orioltobar/shutter_automation/hardware/schemes/shutters.kicad_pcb

## KiCad design ESP32-S3/ESP32-S3.kicad_sch

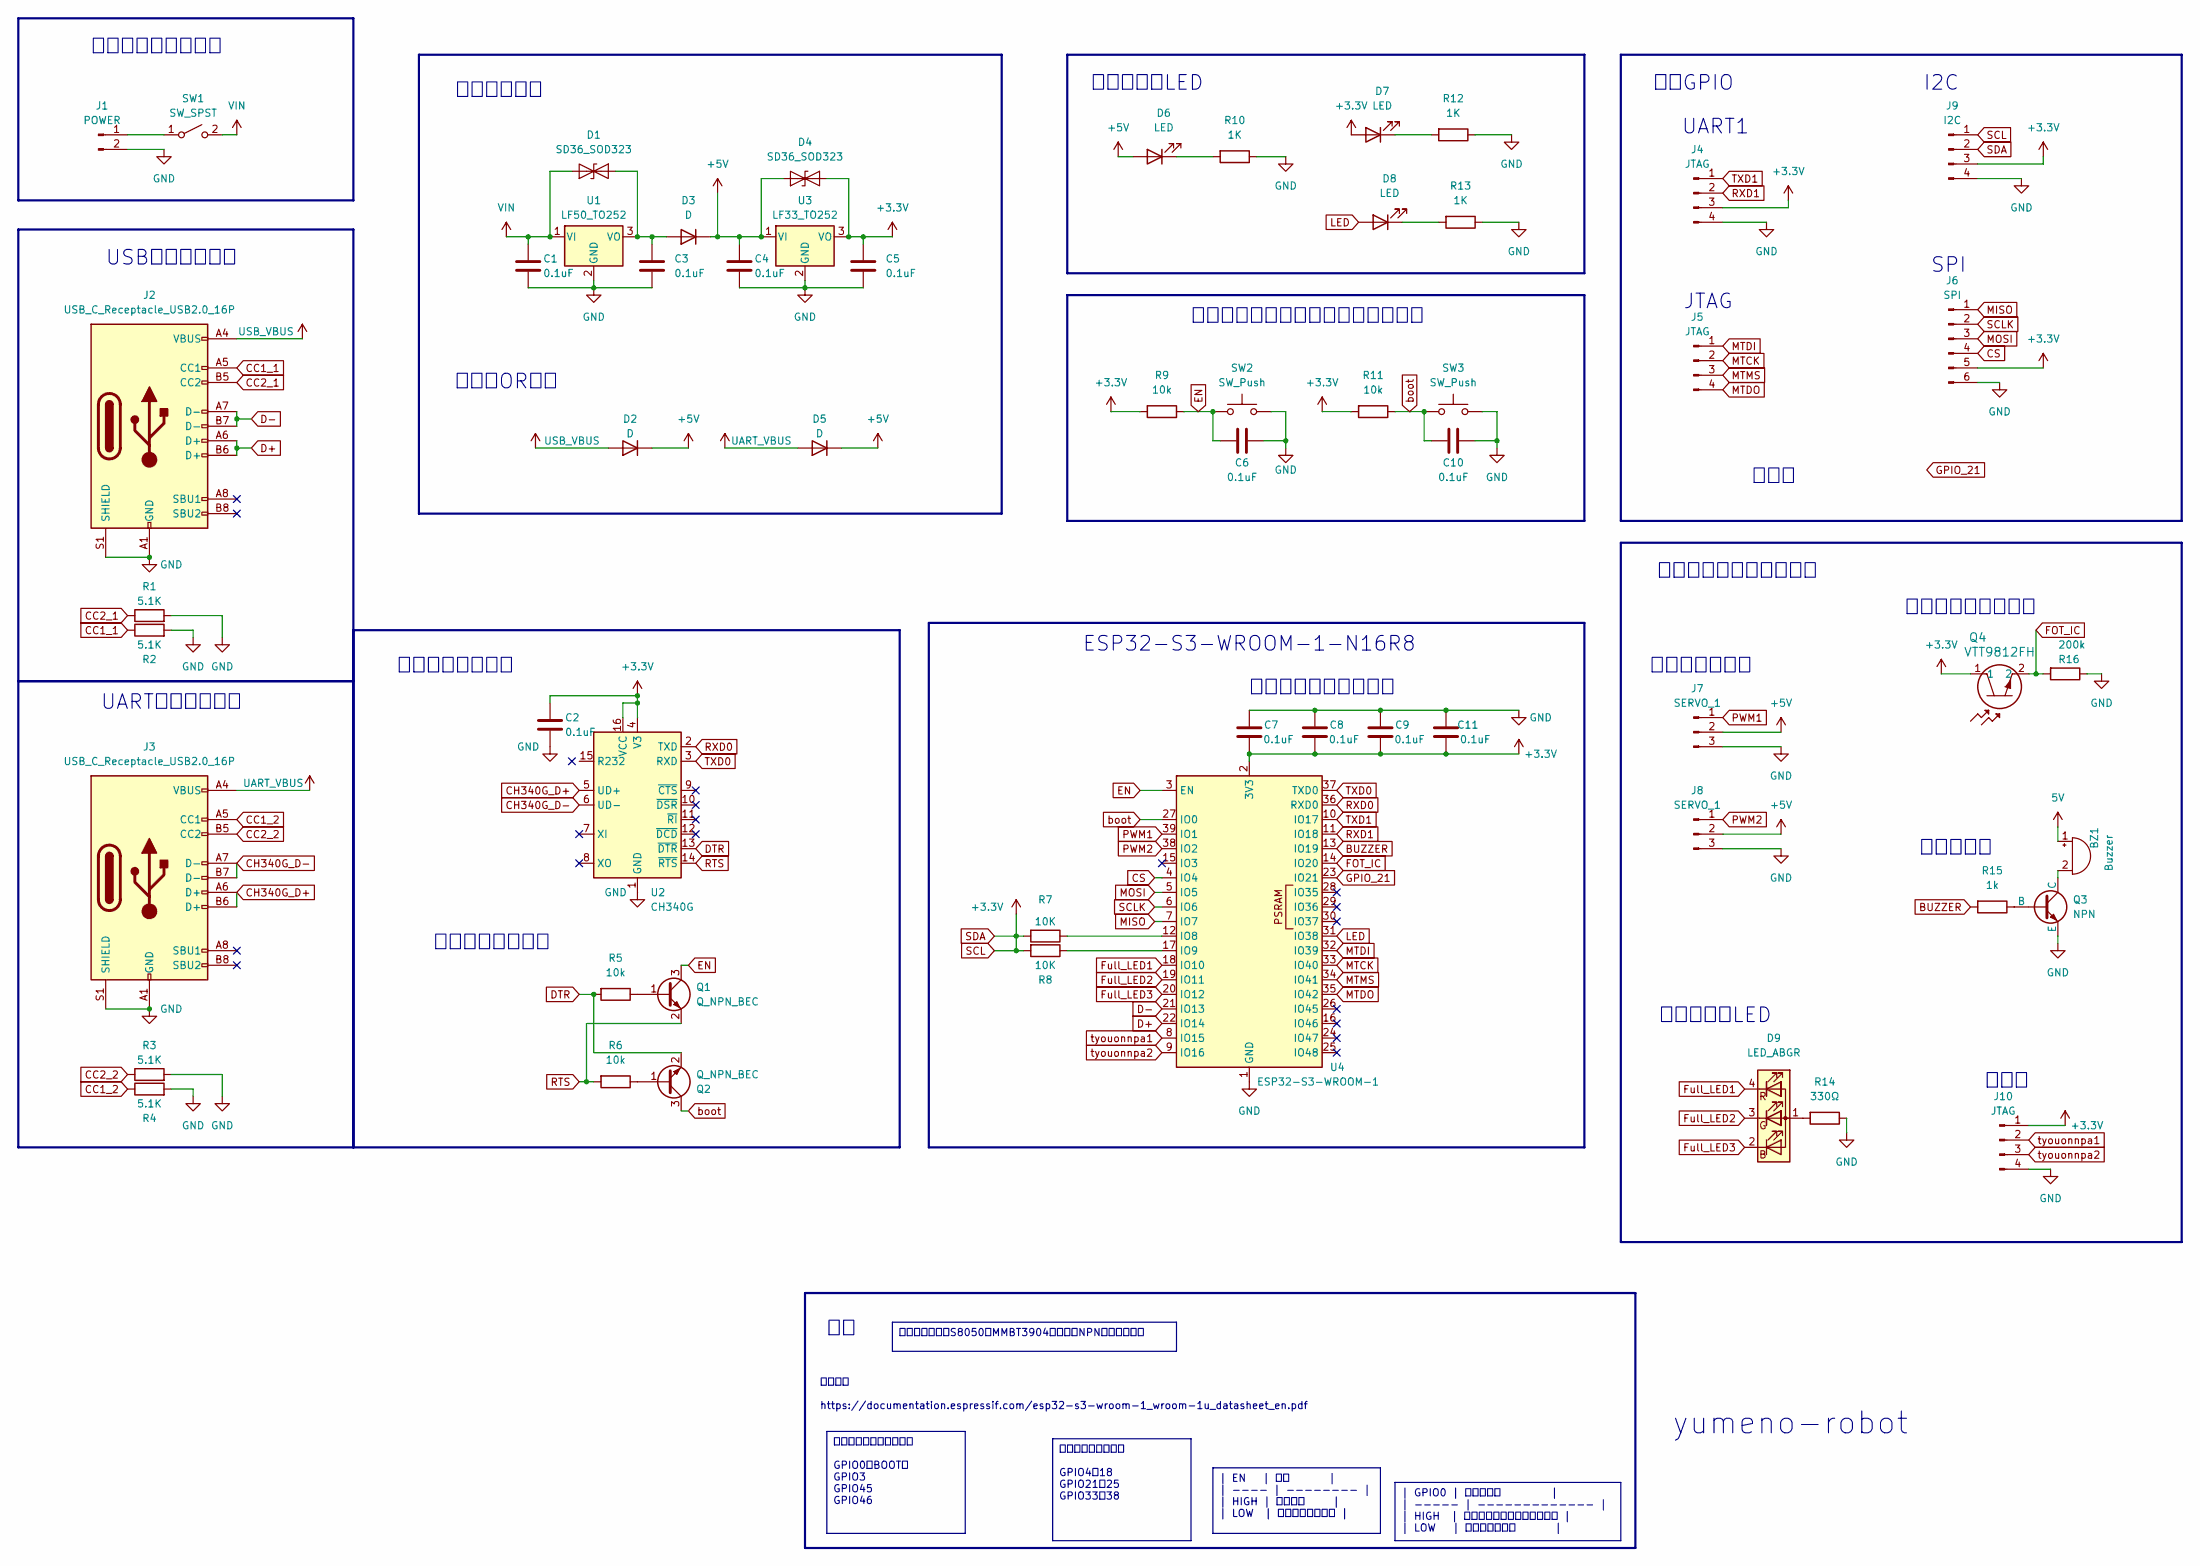
[picture p10: schematic ESP32-S3.kicad_sch]

Parts:
BZ1: Buzzer; buzzer
C1, C2, C3, C4, C5, C6, C7, C8, C9, C10, C11: 0.1uF
D1, D4: SD36_SOD323; D_SOD-323
D2, D3, D5: D
D6, D7, D8: LED
D9: LED_ABGR
J1: POWER
J2, J3: USB_C_Receptacle_USB2.0_16P
J4, J5, J10: JTAG
J6: SPI
J7, J8: SERVO_1
J9: I2C
Q1, Q2: Q_NPN_BEC
Q3: NPN; TSOT-23
Q4: VTT9812FH; NJL7502R
R1, R2, R3, R4: 5.1K
R5, R6, R9, R11: 10k
R7, R8: 10K
R10, R12, R13: 1K
R14: 330Ω
R15: 1k; R_0805_2012Metric
R16: 200k; R_0805_2012Metric
SW1: SW_SPST
SW2, SW3: SW_Push
U1: LF50_TO252; TO-252-2
U2: CH340G; SOIC-16_3.9x9.9mm_P1.27mm
U3: LF33_TO252; TO-252-2
U4: ESP32-S3-WROOM-1

Connections:
5V: BZ1.1 (+)
+3.3V: C2.1, C5.1, C7.1, C8.1, C9.1, C11.1, D4.2 (A2), D7.2 (A), J4.3, J6.5, J9.1, J9.2, J9.3, J10.1, Q4.1, R7.2, R8.2, R9.2, R11.2, U2.4 (V3), U2.16 (VCC), U3.3 (VO), U4.2 (3V3)
+5V: C4.1, D2.1 (K), D3.1 (K), D4.1 (A1), D5.1 (K), D6.2 (A), J7.2, J8.2, U3.1 (VI)
BUZZER: R15.2, U4.13 (IO19)
CC1_1: J2.A5 (CC1), R2.1
CC1_2: J3.A5 (CC1), R4.1
CC2_1: J2.B5 (CC2), R1.1
CC2_2: J3.B5 (CC2), R3.1
CH340G_D+: J3.A6 (D+), J3.B6 (D+), U2.5 (UD+)
CH340G_D-: J3.A7 (D-), J3.B7 (D-), U2.6 (UD-)
CS: J6.4, U4.4 (IO4)
D+: J2.A6 (D+), J2.B6 (D+), U4.22 (IO14)
D-: J2.A7 (D-), J2.B7 (D-), U4.21 (IO13)
DTR: Q2.2 (E), R5.2, U2.13 (~DTR)
EN: C6.1, Q1.3 (C), R9.1, SW2.1, U4.3 (EN)
FOT_IC: Q4.2, R16.2, U4.14 (IO20)
Full_LED1: D9.4 (RK), U4.18 (IO10)
Full_LED2: D9.3 (GK), U4.19 (IO11)
Full_LED3: D9.2 (BK), U4.20 (IO12)
GND: C1.2, C2.2, C3.2, C4.2, C5.2, C6.2, C7.2, C8.2, C9.2, C10.2, C11.2, J1.2, J2.A1 (GND), J2.A12 (GND), J2.B1 (GND), J2.B12 (GND), J2.S1 (SHIELD), J3.A1 (GND), J3.A12 (GND), J3.B1 (GND), J3.B12 (GND), J3.S1 (SHIELD), J4.4, J6.6, J7.3, J8.3, J9.4, J10.4, Q3.3 (E), R1.2, R2.2, R3.2, R4.2, R10.1, R12.1, R13.1, R14.1, R16.1, SW2.2, SW3.2, U1.2 (GND), U2.1 (GND), U3.2 (GND), U4.1 (GND), U4.40 (GND), U4.41 (GND)
GPIO_21: U4.23 (IO21)
LED: D8.2 (A), U4.31 (IO38)
MISO: J6.1, U4.7 (IO7)
MOSI: J6.3, U4.5 (IO5)
MTCK: J5.2, U4.33 (IO40)
MTDI: J5.1, U4.32 (IO39)
MTDO: J5.4, U4.35 (IO42)
MTMS: J5.3, U4.34 (IO41)
unnamed: BZ1.2 (-), Q3.1 (C)
unnamed: C3.1, D1.2 (A2), D3.2 (A), U1.3 (VO)
unnamed: D6.1 (K), R10.2
unnamed: D7.1 (K), R12.2
unnamed: D8.1 (K), R13.2
unnamed: D9.1 (A), R14.2
unnamed: J1.1, SW1.1 (A)
unnamed: Q1.1 (B), R5.1
unnamed: Q2.1 (B), R6.1
unnamed: Q3.2 (B), R15.1
unnamed: R7.1, U4.12 (IO8)
unnamed: R8.1, U4.17 (IO9)
PWM1: J7.1, U4.39 (IO1)
PWM2: J8.1, U4.38 (IO2)
RTS: Q1.2 (E), R6.2, U2.14 (~RTS)
RXD0: U2.2 (TXD), U4.36 (RXD0)
RXD1: J4.2, U4.11 (IO18)
SCLK: J6.2, U4.6 (IO6)
TXD0: U2.3 (RXD), U4.37 (TXD0)
TXD1: J4.1, U4.10 (IO17)
UART_VBUS: D5.2 (A), J3.A4 (VBUS), J3.A9 (VBUS), J3.B4 (VBUS), J3.B9 (VBUS)
USB_VBUS: D2.2 (A), J2.A4 (VBUS), J2.A9 (VBUS), J2.B4 (VBUS), J2.B9 (VBUS)
VIN: C1.1, D1.1 (A1), SW1.2 (B), U1.1 (VI)
boot: C10.1, Q2.3 (C), R11.1, SW3.1, U4.27 (IO0)
tyouonnpa1: J10.2, U4.8 (IO15)
tyouonnpa2: J10.3, U4.9 (IO16)

Notes on the sheet:
安全に使えるゾーン GPIO4〜18 GPIO21〜25 GPIO33〜38
| GPIO0 | 起動モード | | ----- | ------------- | | HIGH | 通常起動（プログラム実行） | | LOW | 書き込みモード |
トランジスタはS8050やMMBT3904あたりのNPNトランジスタ
起動時に状態を読まれる GPIO0（BOOT） GPIO3 GPIO45 GPIO46
| EN | 状態 | | ---- | -------- | | HIGH | 動作する | | LOW | リセット（停止） |
フルカラーLED
SPI
ESP32-S3-WROOM-1-N16R8
シリアル変換回路
スピーカー
UART書き込み回路
自動書き込み回路
電源供給コネクター
JTAG
カリキュラム内必要回路
超音波
USB書き込み回路
フォトトランジスタ
I2C
デバック用LED
電源系OR回路
UART1
手動書き込み 手動リセット 回路
電圧変換回路
拡張GPIO
参考文献 https://documentation.espressif.com/esp32-s3-wroom-1_wroom-1u_datasheet_en.pdf
バイパスコンデンサー
サーボモーター
その他
yumeno-robot
