orioltobar/shutter_automation/hardware/arduino/include/api.h

#ifndef API_H
#define API_H

void init_api();
void check_api();
void set_on_up_api_callback(void (*callback)());
void set_on_up_with_blind_api_callback(void (*callback)(BlindType blind_type));
void set_on_down_api_callback(void (*callback)());
void set_on_down_updated_api_callback(void (*callback)());
void set_on_down_with_blind_api_callback(void (*callback)(BlindType blind_type));
void set_on_up_updated_api_callback(void (*callback)());
void set_on_stop_with_blind_api_callback(void (*callback)(BlindType blind_type));

#endif
