orioltobar/shutter_automation/(commit log)

2024-09-04 Release 0.1
    [shutters.kicad_pcb, shutters.kicad_sch]
2025-09-21 Implemented stop behaviour for hardware button
